dimitris-chatzoulis/lm386-guitar-amplifier/LM386_Guitar_Amp.asc

C1: cap; 58n
C2: cap; 100µ
C3: cap; 100n
C4: cap; 58n
C5: cap; 220µ
C6: cap; 100n
J1: njf; BF245C
R1: res; 1.5Meg
R2: res; {22k*(1-a)}
R3: res; {22k*a}
R4: res; 5k
R5: res; {10k*b}
R7: res; 10
R8: res; 8
U1: LM386
V1: voltage; SINE(0 10m 500); AC 1
V2: voltage; 9
Named nets: 0, Vpower, Vout_max, Vin, Vin_jfet, Vout_jfet
.include LM386.sub
.param a=0.99999
.tran 0 100m 90m 10u
.ac dec 100 1 70k
.param b=0.0001
.MODEL BF245C NJF(
+ VTO=-5.0014
+ BETA=5.43157E-4
+ BETATCE=-0.5
+ LAMBDA=2.71505E-2
+ RD=1.20869E1
+ RS=1.20869E1
+ CGS=2.00000p
+ CGD=2.00000p
+ PB=1.24659
+ IS=3.64346E-16
+ XTI=3
+ AF=1
+ FC=0.5
+ N=1
+ NR=2
+ MFG=PHILIPS
+)
.op
